cybrnode/usb-relay/README.md

# USB RELAY

## Description

USB-RELAY could be operated using serial commands. This device is designed to enable the capability of interfacing with embedded computers that don't have a GPIO interface. 

## Hardware

1. Arduino Nano
2. Relay (5v) x 2

## Software Technologies

1. VsCode (IDE)
2. Platform IO (Framework)

## Additional Equipment for assembly

1. WireBoard
2. T-Block (Tri) * 2
3. Solder + Soldering wire

### Varients

See the varients info in their respective branches

main -> varient-1:arduino-name
