cybrnode/usb-relay/circuit-diagram/usb-relay.sch

## KiCad design circuit-diagram/usb-relay.sch (2021-03-12)

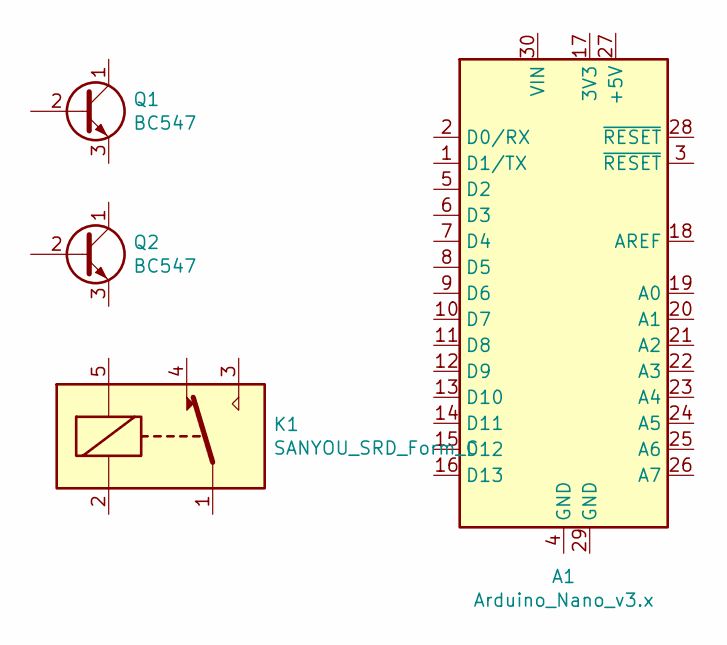
[picture p1: schematic usb-relay.sch]

Parts:
A1: Arduino_Nano_v3.x; Arduino_Nano
K1: SANYOU_SRD_Form_C; Relay_SPDT_SANYOU_SRD_Series_Form_C
Q1: BC547; Relay_SPDT_SANYOU_SRD_Series_Form_C
Q2: BC547; TO-92_Inline
