cybrnode/usb-relay/(commit log)

2021-03-12 junk files added
    [project-1.kicad_pcb, project-1.sch]
2021-03-13 first design
    [pcb1.kicad_pcb, pcb1.sch]
2021-03-13 completely on bottom copper
    [pcb1.kicad_pcb]
2021-03-15 Restructured and also added Frimware
    [project-1.kicad_pcb, project-1.sch]
2021-03-16 Renamed pcb folder
    [pcb1.kicad_pcb, pcb1.sch]
2021-03-22 Updated 1mm trace - still on Nano
    [pcb1.kicad_pcb]
2021-03-24 On attiny85 with UART Serial Support - New firmware included
    [pcb1.kicad_pcb, pcb1.sch]
2021-03-28 fragmented repo message
    [pcb1.kicad_pcb, pcb1.sch, project-1.kicad_pcb, project-1.sch]
2021-11-16 At "circuit-diagram" added ".gitignore" file
2021-11-16 RENAMED PROJECT: "project-1" -> "usb-relay"
    [usb-relay.kicad_pcb, usb-relay.sch]
